josephgalloway321/IoT-Shed/README.md

# IoT Shed

Shed

The IoT Shed is a project focused on adding automation to an ordinary shed. Please watch this short [demonstration](https://youtu.be/3eUKjTSdYpM). The project includes remote light control, cooling the inside of the shed, and a website to control and monitor information remotely. My goal for this project was to help my dad automate some tasks in his shed while using skills that I learned from a course I recently took at Arizona State University, Programming for the Internet of Things.

This repository includes everything needed to make this project on your own. Please feel free to fork the code and schematics and make your own version. If you do, then please share your final version with me! I'd love to see how you improved upon my design for your own shed. I included a [future work](#future-work) section to provide some ideas.

___
## About this document
This document has two sections - a section giving an [overview](#overview) of how everything works and a section that provides a [step-by-step guide](#step-by-step-guide) for replicating this project on your own.

___
## Table of Contents
[Overview](#overview)
- [Website](#website)
- [Light Control](#light-control)
- [Shed Cooling](#fan-cooling)
- [Ceiling Control](#ceiling-control)
- [Battery Monitoring](#battery-monitoring)

[Step-by-Step Guide](#step-by-step-guide)
- [Components](#components)
- [Circuit](#circuit)
- [Code]()
- [Enclosure](#enclosure)
- [Bill of Materials](#bill-of-materials)
- [Future Work](#future-work)
- [Acknowledgements](#acknowledgments)

___
## Overview
This section shows a high level view of how everything in the IoT shed works. Please refer to the [Step-by-Step Guide](#step-by-step-guide) for instructions on how to make the project yourself.

This [video](https://www.youtube.com/watch?v=PkzvmJoyXTg) shows a demonstration with everything working.

### Website
The website is broken into four sections: ceiling slits, battery level, occupancy, and the temperature. The ceiling slits section is for monitoring the state of the ceiling slits, whether rain has been detected or not, and the status of the air compressor and releae valve. The battery level section is meant to indicate the current charge on the battery. The occupancy section is for monitoring if someone is currently in the shed or not. This will determine the status of the lights. The temperature section is for monitoring the indoor and outdoor temperatures as well as the state of the fan.

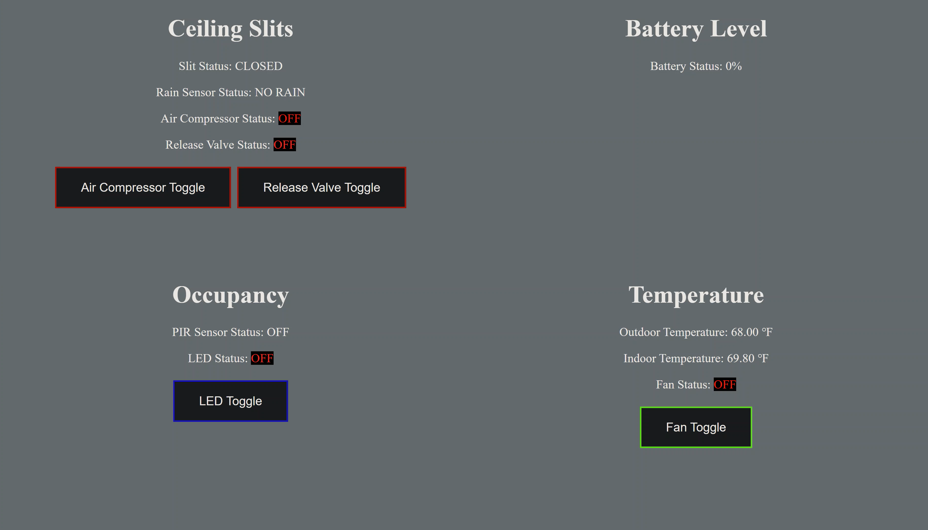
[picture p1: Images/website_design.png]


The ESP32 Relay Board will serve as a server that hosts the website. Anyone connected to the same WiFi can access the website. A simple concept visual is shown below.

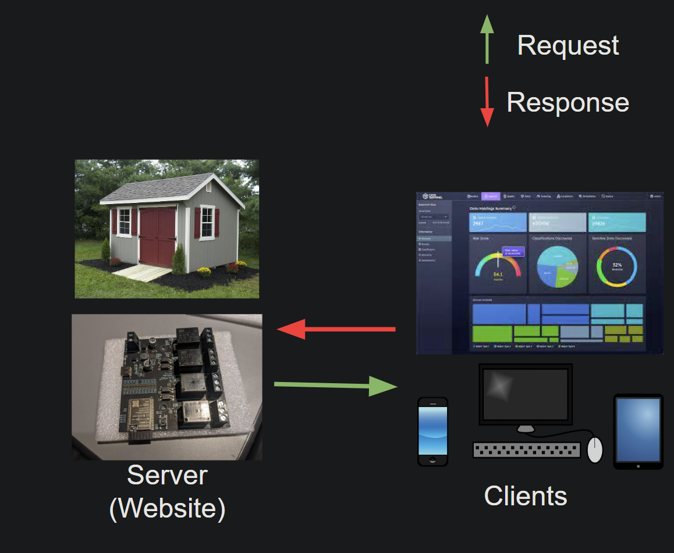
[picture p2: Images/concept.png]


Users can toggle the air compressor, release valve, fan, and lights using the website. The status of each will automatically update on the website. These toggle buttons were included mainly for testing, but I kept them so users can still have access to them. However, the goal of this project is to automate processes, so the buttons are not meant to be used often. 

### Light Control
My original intention was to automate the shed lights so that they turned on when someone entered, stayed on as long as someone was moving in the shed, and turned off when no one occupied the shed. Because of my limited time, I have not completed this section yet. The device I plan to use is called a Passive Infrared (PIR) sensor. More details on this sensor can be found in the [components](#components) section in the [step-by-step guide](#step-by-step-guide). For now, users can toggle the lights remotely using the website. I intend on completing this section soon. The LED strips are shown below.

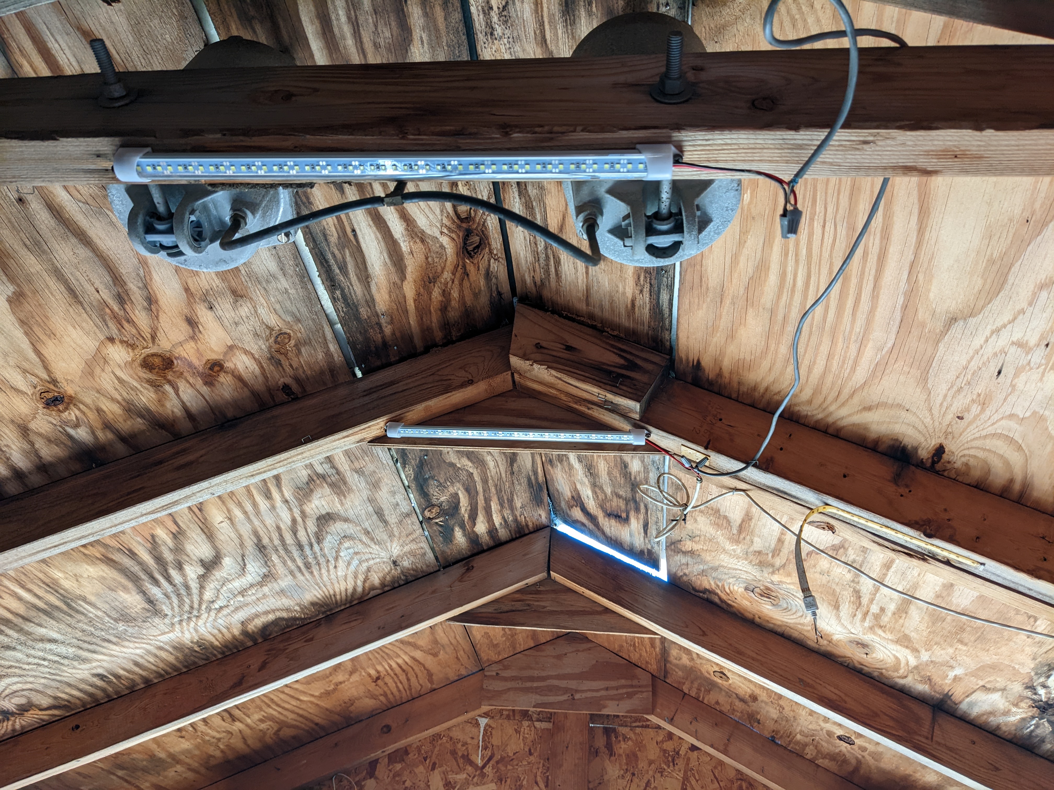
[picture p3: Images/lights.jpg]


### Shed Cooling
My home in Texas gets very hot. Throughout most of the year, the temperature inside my dad's shed is much hotter than it is outside. My dad's shed currently uses a fan and pneumatic actuators to open and close ceiling slits to cool down the shed. Before this project, both of these were controlled with switches. Now, both are controlled automatically using sensors. The image below shows the pneumatic actuators and the ceiling slits when they're closed.

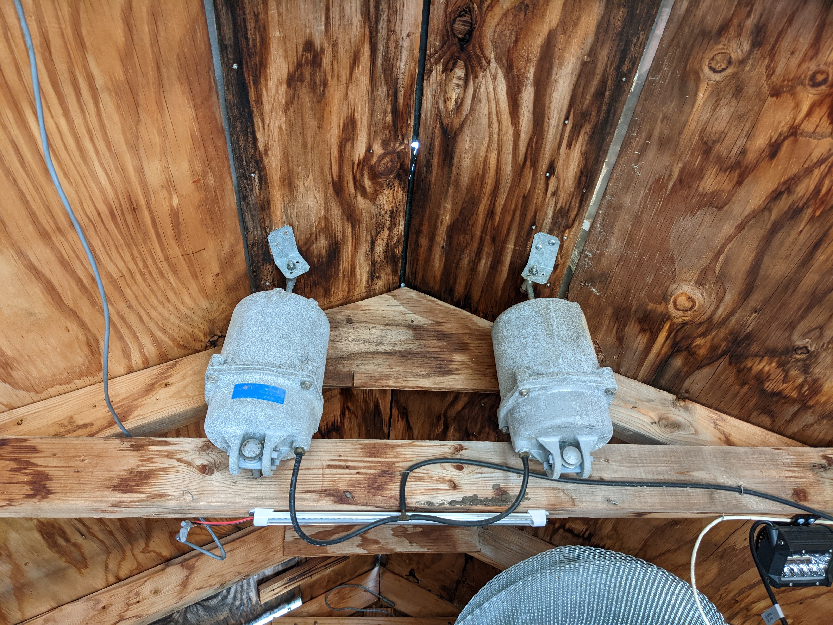
[picture p4: Images/actuators.jpg]


When the outside temperature rises 5&#176;F above the temperature inside the shed, the air compressor will turn on. The compressor will actuate the two pneumatic actuators installed just below the ceiling slits and open them. The process takes about twenty five seconds then the air compressor shuts off. As long as the ceiling slits are open, the air compressor will not turn on again regardless of the temperature differential. The ceiling slit status is determined by the limit switch installed just below one of the ceiling slits. The indoor and outdoor temperature sensors are shown below. The images below show what the ceiling slits look like when they're open.

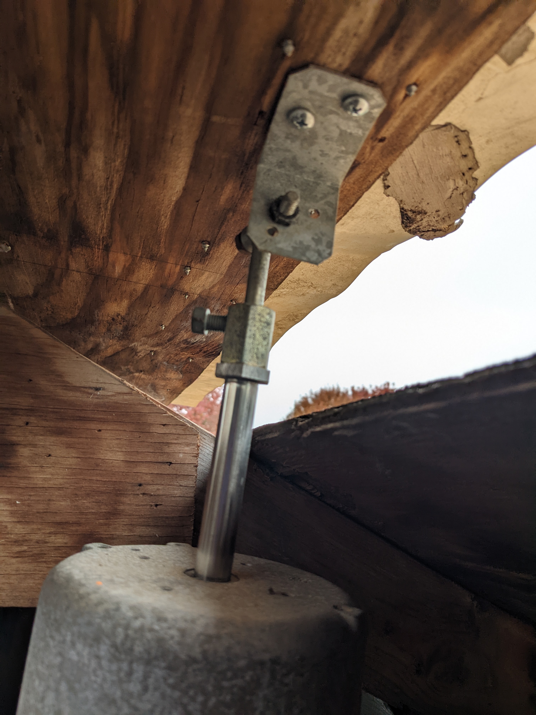
[picture p5: Images/ceiling_slits.jpg]

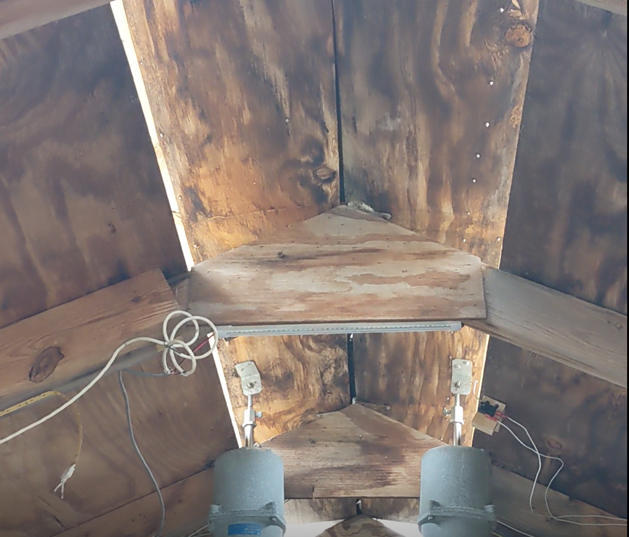
[picture p6: Images/ceiling_slits_two.png]


When the same temperature differential happens, the fan will turn on for a specific amount of time then pause for a different amount of time. This is meant to prevent the fan from running all day and draining the battery. The fan will help cool down the shed a little and keep air flowing, but it will not cool the shed down enough to change the temperature differential, which is why the fan should be paused after being used.

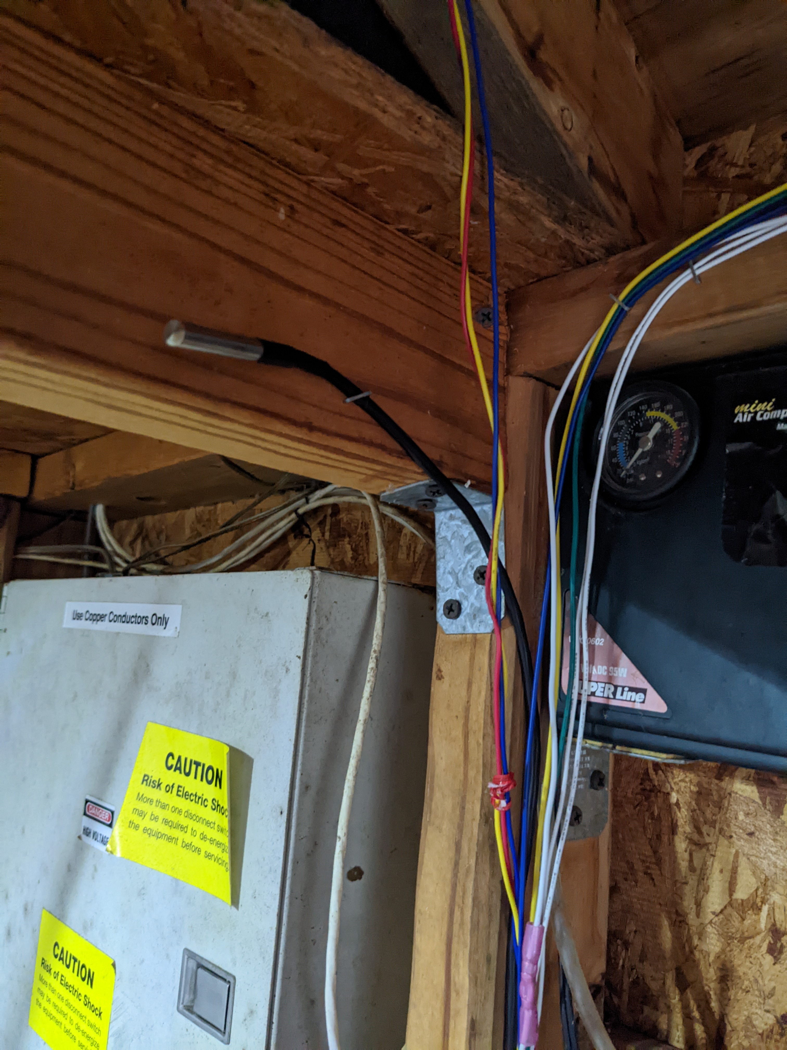
[picture p7: Images/indoor_temp.jpg]

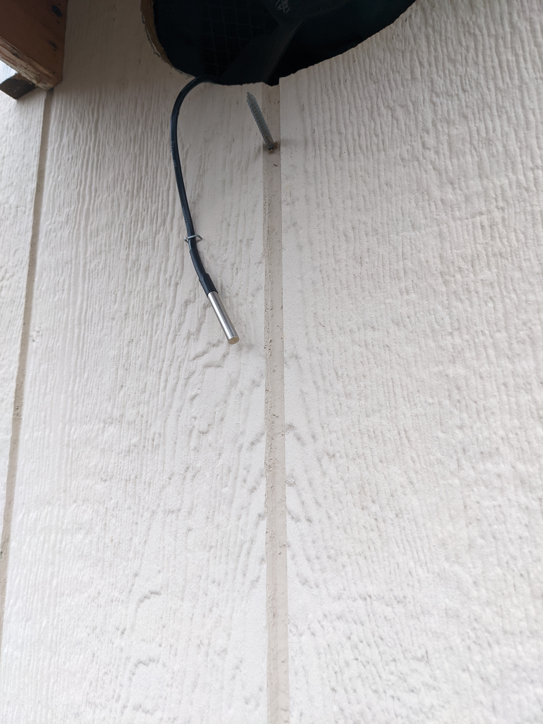
[picture p8: Images/outdoor_temp.jpg]


### Ceiling Control
As explained in the previous section, the ceiling slits are opening using an air compressor. When rain is detected by the rain sensor, the same slits are closed using a release valve. The processor for closing the slits is about ten seconds.

There is a pneumatic system made up of pipes used to control the air flow into and out of the pnemuatic actuators. An image of what I used is shown below. However, this is not necessary. All that is needed is the tubing shown in the bill of materials. This is for connecting the air compressor and the release valve to the pneumatic actuators.

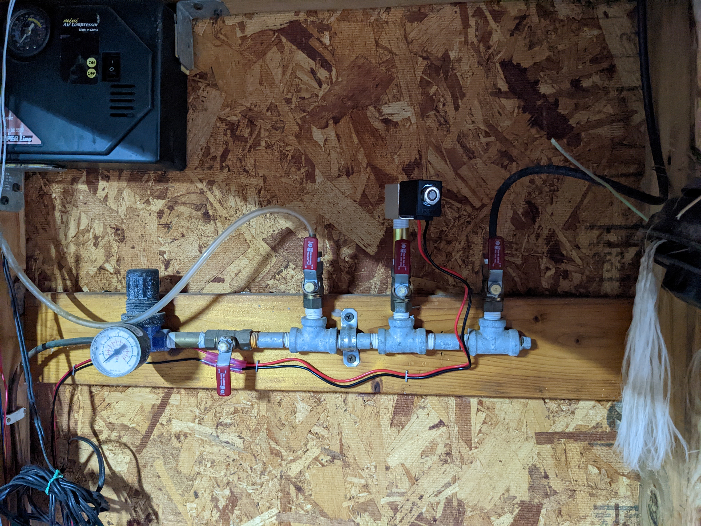
[picture p9: Images/pneumatic_valves.jpg]


### Battery Monitoring
My original intention was to show the current charge on the battery using the website. If the charge on the battery dropped below a set value, then an email would be sent to the user to charge the battery. Because of my limited time, I have not completed this section yet. The device I plan to use is an ina260 power sensor from Adafruit. More details on this sensor can be found in the [components](#components) section in the [step-by-step guide](#step-by-step-guide). For now, users can see where the battery charge will be located when this part is complete. The battery sensor I intend on using is shown below.

___
## Step-by-Step Guide
This section is a step-by-step guide for replicating the IoT Shed project. Please refer to the [Overview](#overview) for a high level view of how everything in the IoT shed works. 

### Components
Please begin the project by ordering all the components found in the [bill of materials](#bill-of-materials) section. It is assumed you already have a shed and a laptop to program. 

I highly recommend testing each component and circuit individually to make sure everything works the way it's intended. This will also give you some familiarity with everything at the start. More information for each sensor can be found on the website links found in the [bill of materials](#bill-of-materials) section. Each component shown below has a link to a brief tutorial showing you how to use them and a simple circuit for testing.
- [PIR Sensor](https://learn.adafruit.com/pir-passive-infrared-proximity-motion-sensor/overview)
- [Power Sensor](https://learn.adafruit.com/adafruit-ina260-current-voltage-power-sensor-breakout)
- [Temperature sensor](https://www.adafruit.com/product/381)
- [Limit Switch](https://youtu.be/6wuInF9Yw08)
- [Rain sensor](https://www.kemo-electronic.de/en/House/Garden/M152-Rain-Sensor-12-V-DC.php)

Please note that the TTGO T-U2T USB to TTL device found in the [bill of materials](#bill-of-materials) is required to program the ESP32 Relay Board. 

The limit switch needs a way to stay fixed under the ceiling slits so it can turn on and off when the slits are open and closed. The image below shows how I solved this issue. 

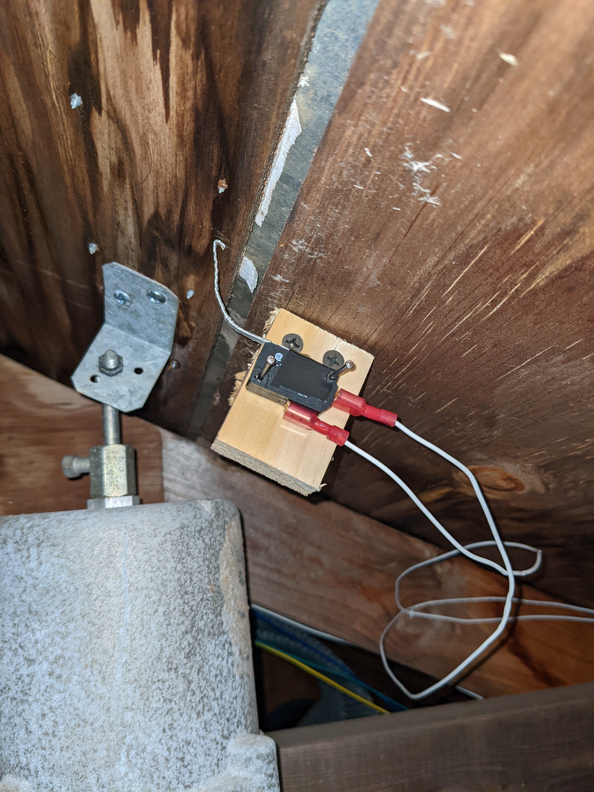
[picture p10: Images/limit_switch.jpg]

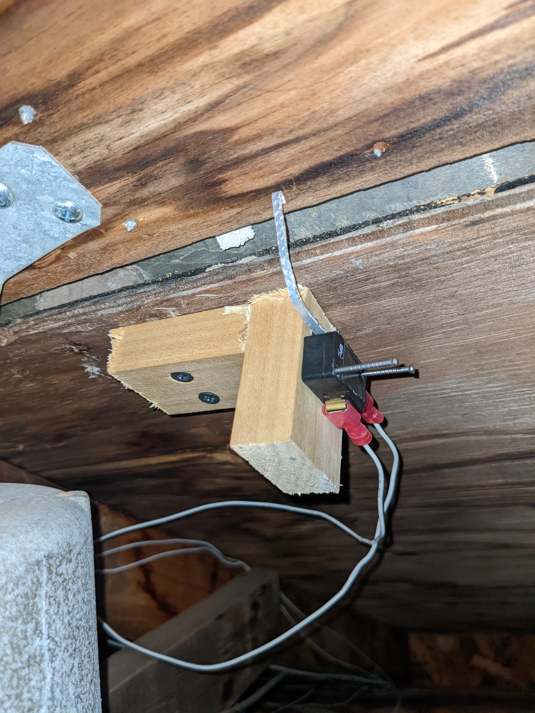
[picture p11: Images/limit_switch_two.jpg]


This device is made up of two 2"x4" blocks, four wood screws, two nails, and a thin piece of sheet metal to extend the limit switch lever. All of these materials are in the bill of materials. Screw the two blocks at a right angle and to a fixed part of the shed ceiling. Use two nails to fix the limit switch. Cut and glue a thin metal strip to the limit switch. Use two spade connectors to electrically connect to the limit switch.

The rain sensor needs to be placed at an angle so water will runoff of it and not collect onto the surface. All of the materials shown are in the bill of materials. Four screws were driven into the metal bracket and shed wall. The rain sensor was secured using metal wire. Test that water will run off the roof onto the sensor before permenantly installing.

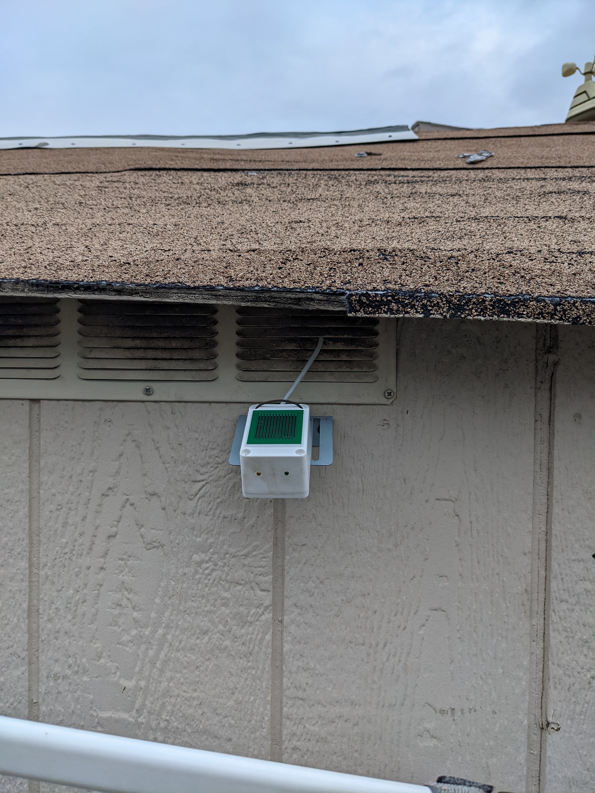
[picture p12: Images/rain_sensor.jpg]

Shed

### Circuit
When I began this project, I planned on getting all power from the 12V DC car battery already powering other devices in the shed. To prevent damage to components, I decided to use a buck regulator between the battery power and everything I planned to power. This regulator restricted the current to a maximum of 1 Amp. Please keep in mind the maximum allowable current for each device you plan on using.

The system's circuit is shown below. Note that the accessible GPIO pins have been placed on the top and bottom of the ESP32 relay board for readability. Also, the pull-up resistors shown are all 4.7k Ohm. Please note that the PIR sensor and the power sensors are not yet included in the final circuit.

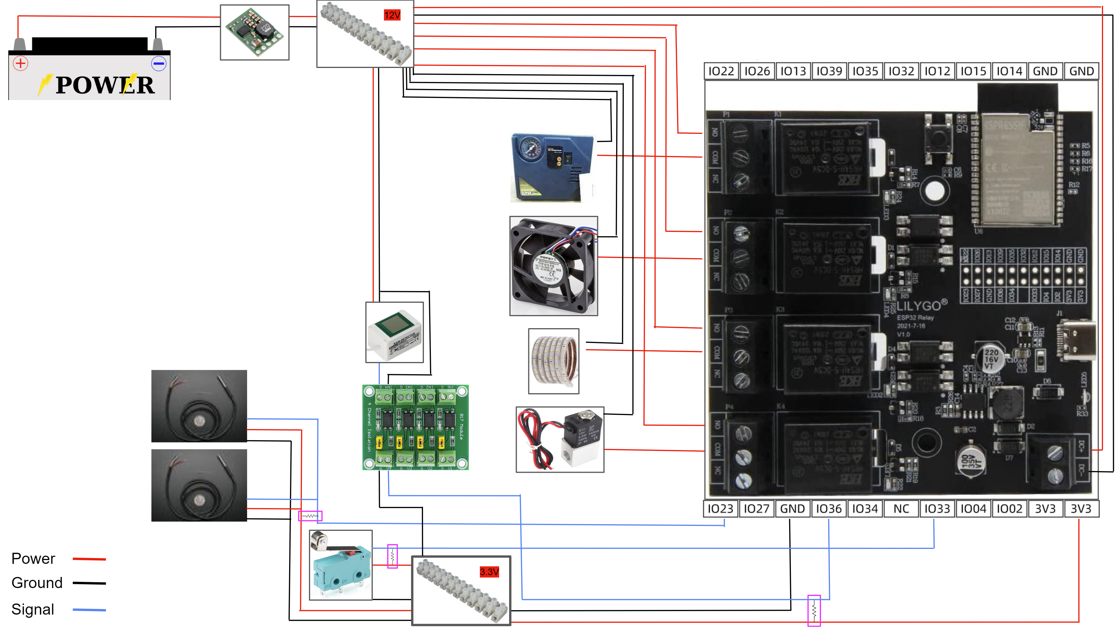
[picture p13: Images/overall_circuit.png]


The red lines indicate power wries, the black lines indicate ground wires, and the blue lines show the signal wires. Please make sure each component is powered and grounded appropriately. Once you have all of the components and tested each one, please assemble the circuit shown above. Note that the length of each wire will depend on how far each component will be placed in the shed relative to the ESP32 Relay Board.

The air compressor, the fan, the release valve, and the led strip are all controlled by the relays because they operate on a much higher voltage than the ESP32 relay board can provide. The other components can be powered using the battery or the 3.3V from the ESP32 relay board. 

When rain is detected, the rain sensor provides a 12V signal. This high voltage signal would destroy the ESP32 relay board if it was plugged directly into one of the GPIO pins. An optocoupler is used as an intermediate so that a 3.3V logic signal is sent to the ESP32 Relay Board when rain is detected.

### Code
There are four files of code: main.ino, index.html, style.css, and script.js. All of these can be found in the src folder in this repository. They are managed on the ESP32 relay board using SPIFFS. The main.ino file is the code for the server, sensor logic, and data transmission. The remaining three files all make up the website design and functionality. 

First, download the following libraries to your computer:
- [AsyncTCP](https://github.com/me-no-dev/AsyncTCP)
- [ESPAsyncWebServer
](https://github.com/me-no-dev/ESPAsyncWebServer)

Using the Arduino IDE, add the above libraries as well as these:
- WiFi.h
- Wire.h
- OneWire.h
- DallasTemperature.h

Next, install SPIFSS using this [tutorial](https://youtu.be/mkXsmCgvy0k). Please watch from 1:54 to 2:43.

Save the main.ino file into a folder labeled "main". Within the main folder, create a new folder labeled "data". Save the HTML, CSS, and Javascript files in this folder. Back in your Arduino IDE, click on "tools", then click on "ESP32 Sketch Data Upload". This will load the files in the data folder for the website. 

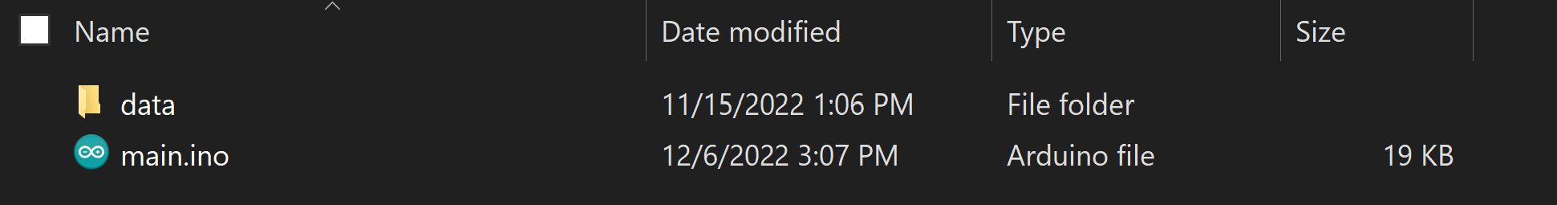
[picture p14: Images/files.png]

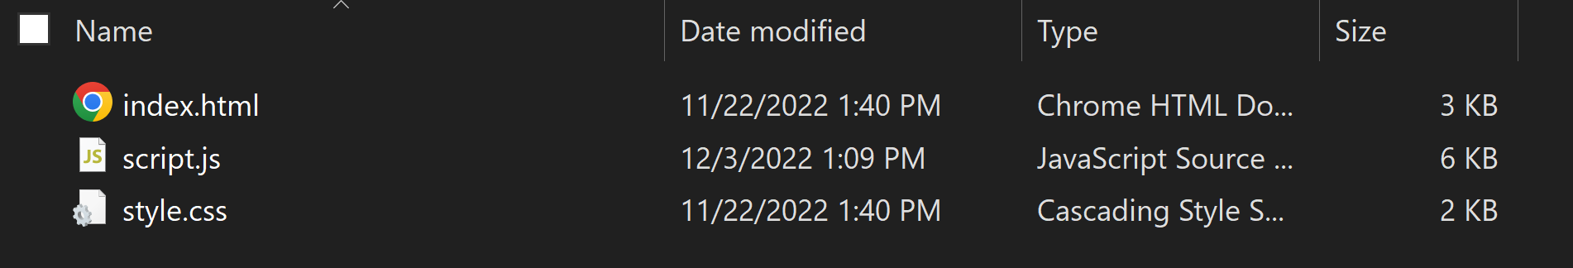
[picture p15: Images/files_two.png]


The next step is to get the wifi information needed to make a static IP address. In the main.ino file, Write in your wifi's SSID and password into the ssid and password variables at the top of the file. Run the program and open the serial monitor. You may need to press the reset button on the ESP32 Relay Board. After the program finishes connecting, the IP Address, Subnet Mask, Gateway IP, and DNS IP will be displayed. Please copy this information to the same variables at the top of the connectToWifiStatic() function. Copy the IP Address and rewrite it into the first line found in the script.js file.

Now, switch the program so it connects the static IP Address you recorded everytime you reset the program. Navigate to the setup function, uncomment the connectToWifiStatic() function, and comment the connectToWifi() function. Save each file, click on "tools", then click on "ESP32 Sketch Data Upload" to update the website information. Run the main.ino file in the Arduino IDE. Open the serial monitor to make sure the ESP32 Relay Board connects correctly. Open a brower and type in the static IP Address shown in the serial monitor. You should see the website pop up with correct sensor information. 

Shed

### Enclosure
The enclosure of the relay board is made out of acrylic and cut using a laser cutter provided by the Fab Lab at Arizona State University. The enclosure file, labeled board_enclosure.pdf, can be found in the additional_documentation folder in this repository.

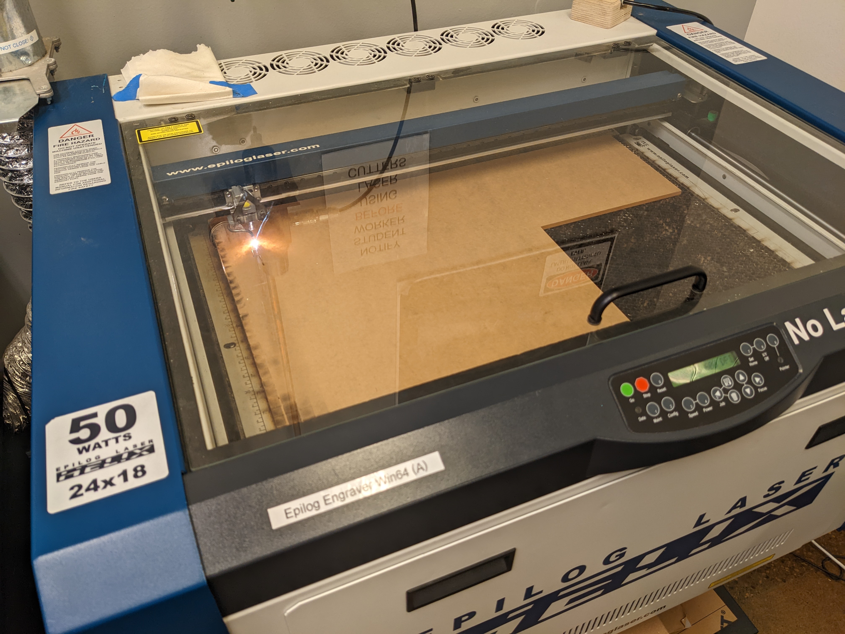
[picture p16: Images/relay_board_enclosure/laser_cutter.jpg]

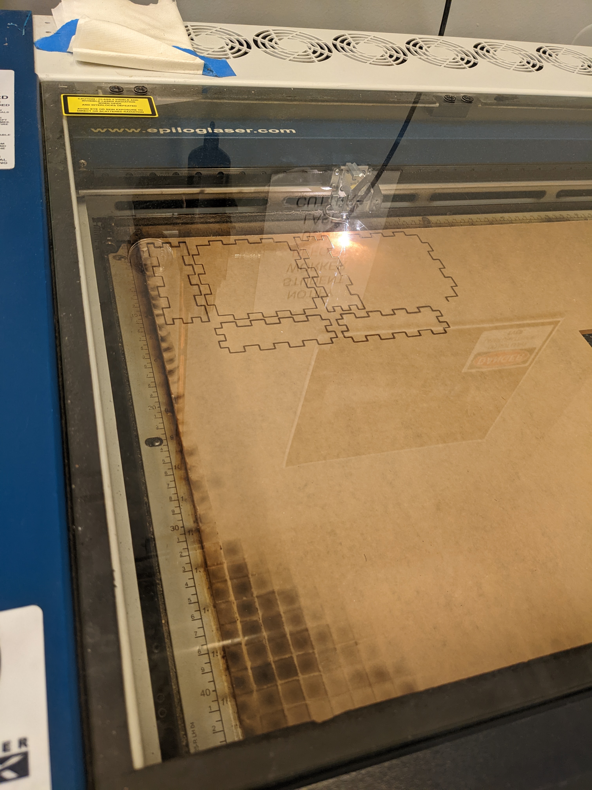
[picture p17: Images/relay_board_enclosure/laser_cutter_II.jpg]

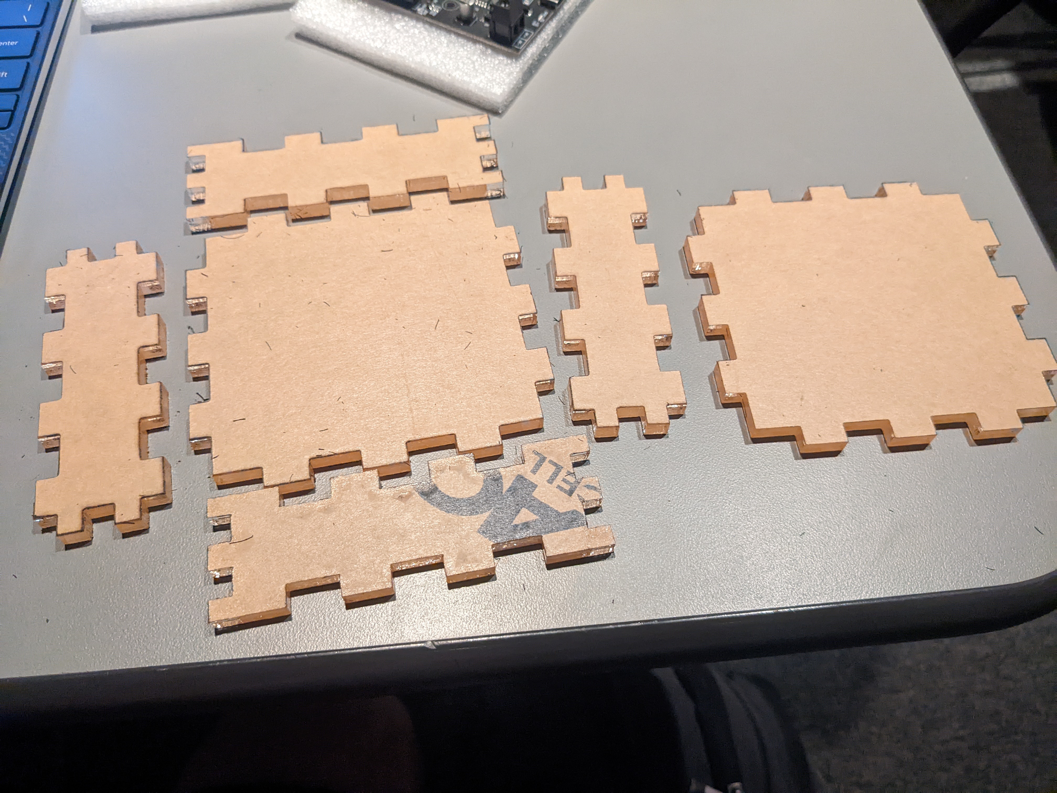
[picture p18: Images/relay_board_enclosure/enclosure.jpg]

Shed

The circuitry is currently not enclosed and exposed to the elements. I plan on making another enclosure for this in the near future.

### Bill of Materials
| Item | Price |
| ---- | ----  |
| [Battery](https://www.walmart.com/ip/EverStart-Value-Lead-Acid-Automotive-Battery-Group-Size-26-12-Volt-525-CCA/482504063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) | $60 |
| [Wire Strippers](https://www.amazon.com/Klein-Tools-Cutter-Stripper-Stranded/dp/B00080DPNQ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) | $20 |
| [Spade Connectors](https://www.amazon.com/TICONN-Disconnect-Connectors-Electrical-Assortment/dp/B08BZ8BLJN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) | $20 |
| [Wire Connectors & Crimpers](https://www.amazon.com/haisstronica-Connectors-Electrical-Waterproof-Removable/dp/B09GLKX7ZX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) | $55 |
| [Wood Screws](https://www.amazon.com/HongWay-Phillips-Assortment-Tapping-Drywall/dp/B08CZJK8SW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) | $8 |
| [Wood Nails](https://www.amazon.com/Premium-Hardware-Assortment-Maximum-Galvanized/dp/B089FLMFPB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) | $7 |
| [Drill](https://www.amazon.com/BLACK-DECKER-Cordless-Driver-BDCDD12C/dp/B0111N8L7I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) | $30 |
| [Breadboard & Jumper Wires](https://www.amazon.com/BOJACK-Values-Solderless-Breadboard-Flexible/dp/B08Y59P6D1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) | $12 |
| [Soldering Kit](https://www.amazon.com/Soldering-Kit-Temperature-Desoldering-Electronics/dp/B07GTGGLXN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) | $20 |
| [Limit Switch](https://www.amazon.com/REDGOOSE-Switch-Normally-3X10PCS-Switches/dp/B0B7DD5SF1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) | $9 |
| [Terminal Blocks](https://www.amazon.com/Terminal-Connector-Electric-Barrier-12-Position/dp/B08NGBQWWT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) | $10 |
| [Pneumatic Actuators](https://www.amazon.com/Baomain-Pneumatic-Cylinder-SC-Screwed/dp/B01F9XZQ1K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) | $21 |
| [Fan](https://www.amazon.com/GDSTIME-80mm-25mm-Brushless-Cooling/dp/B00N1Y50QQ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) | $9 |
| [Air Compressor](https://www.ebay.com/itm/265713472217) | $32 |
| [Passive Infrared (PIR) Sensor](https://www.adafruit.com/product/189) | $10 |
| [Indoor & Outdoor Temperature Sensor](https://www.adafruit.com/product/381) | $10 |
| [Power Sensor](https://www.adafruit.com/product/4226) | $10 |
| [Release Valve](https://www.amazon.com/4inch-Normally-Closed-Electric-Solenoid/dp/B074Z5SDG3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) | $10 |
| [Rain Sensor](https://www.amazon.com/dp/B000NI2QJC?psc=1&ref=ppx_yo2ov_dt_b_product_details) | $35 |
| [LEDs](https://www.amazon.com/WELLUCK-Interior-Trailer-Enclosed-Lighting/dp/B08GG18HVW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) | $20 |
| [ESP32 w/ Relays](https://www.amazon.com/LILYGO-T-Relay-Wireless-Development-Control/dp/B09XX1HL9Z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) | $20 |
| [TTGO T-U2T USB to TTL](https://www.walmart.com/ip/OOKWE-LILYGO-TTGO-T-U2T-USB-To-TTL-Serial-Development-Board-Open-Source-Module/1405355347) | $17 |
| [Wires](https://www.amazon.com/dp/B089CW7YSR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) | $30 |
| [Pneumatic Tubing](https://www.amazon.com/CGELE-Pneumatic-Transfer-OD-39-4Ft-12Meter/dp/B09KBM3J5K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) | $14 |
| [Wood Blocks](https://www.amazon.com/Bright-Creations-Unfinished-Blocks-Crafts/dp/B07R51CY99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) | $12 |
| [Metal Wire](https://www.amazon.com/TecUnite-Aluminum-Bendable-Skeleton-Thickness/dp/B07CQL7Y5B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) | $13 |
| [Metal Bracket](https://www.amazon.com/5pcs-Metal-Bracket-Wide-40x50x50mm/dp/B0BK9XYNDS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) | $15 |
| [Sheet Metal](https://www.amazon.com/Sheet-Metal-Stock-Made-USA/dp/B000H5W3PI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) | $7 |

### Future Work
This section provides some ideas for you to build upon my version. They're just ideas I thought of while I was working on this project.
- Bluetooth speakers
- External antenna
- Fan to keep relay board cool with a temperature sensor dedicated to the relay board
- Better website design
- Solar panel to charge the battery
- Battery monitor for solar panel

### Acknowledgments
The following is my work cited:
- ShawnHymel. (2018, November 1). How to make an Arduino WebSocket server with an ESP32. YouTube. Retrieved November 5, 2022, from https://www.youtube.com/watch?v=ZbX-l1Dl4N4
- YouTube. (2019, January 6). PC817 adapter module Optocoupler with Arduino - Zonemaker.com. YouTube. Retrieved November 6, 2022, from https://www.youtube.com/watch?v=dD4r5I7h4Xg
- How to create a web server (with WebSockets) using an ESP32 in Arduino. Shawn Hymel. (2019, September 9). Retrieved November 7, 2022, from https://shawnhymel.com/1882/how-to-create-a-web-server-with-websockets-using-an-esp32-in-arduino/ 
- Googlecreativelab, Magenta, McDonald, K., & RRD Labs. (n.d.). Googlecreativelab/open-NSYNTH-super: Open NSYNTH super is an experimental physical interface for the NSYNTH algorithm. GitHub. Retrieved December 8, 2022, from https://github.com/googlecreativelab/open-nsynth-super#how-it-works 
- Gowda, T. (n.d.). Tejaswigowda/AME494-598FALL2022. GitHub. Retrieved December 8, 2022, from https://github.com/tejaswigowda/ame494-598Fall2022 

[Back to Top of Webpage](#iot-shed)
