josephgalloway321/IoT-Shed/Images/air_compressor.jpg

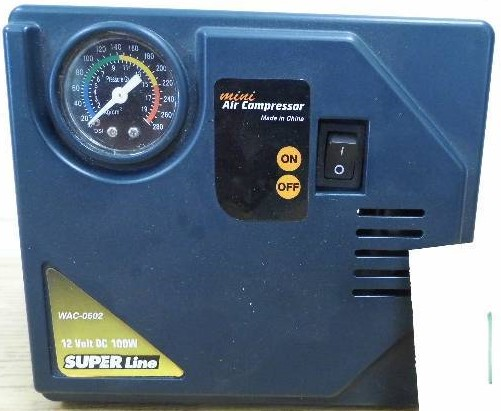
Images/air_compressor.jpg
