josephgalloway321/IoT-Shed/Images/battery.jpg

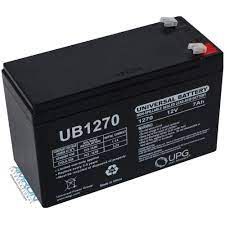
Images/battery.jpg
