josephgalloway321/IoT-Shed/Images/led.jpg

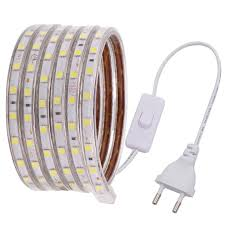
Images/led.jpg
