josephgalloway321/IoT-Shed/Images/optocoupler.jpg

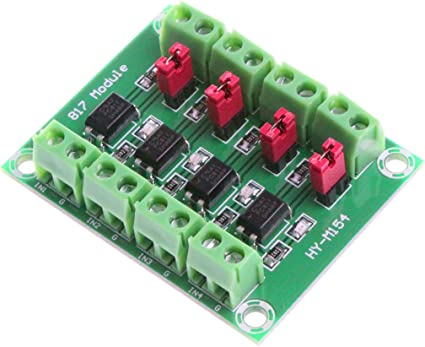
Images/optocoupler.jpg
