josephgalloway321/IoT-Shed/Images/pir_sensor.jpg

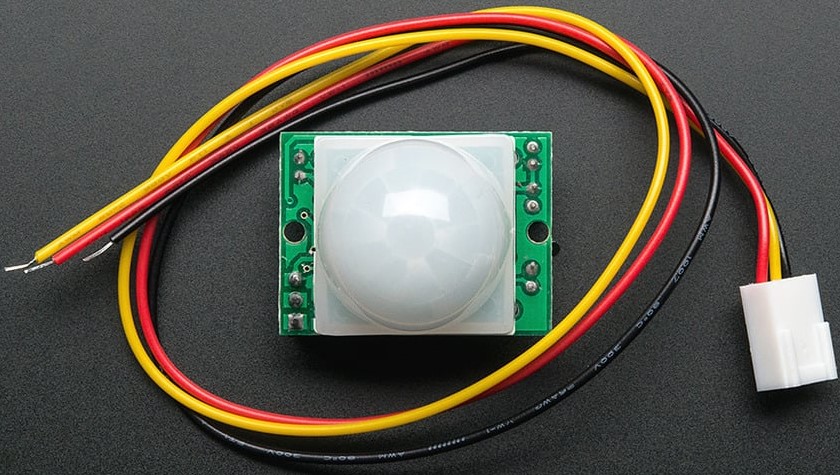
Images/pir_sensor.jpg
