josephgalloway321/IoT-Shed/Images/power_sensor.jpg

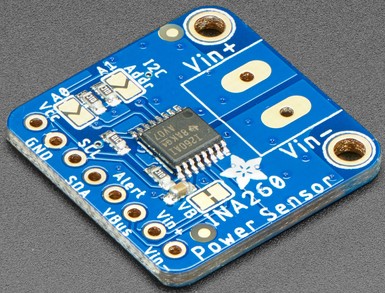
Images/power_sensor.jpg
