josephgalloway321/IoT-Shed/Images/relay_board.jpg

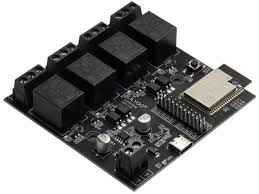
Images/relay_board.jpg
