josephgalloway321/IoT-Shed/Images/release_valve.jpg

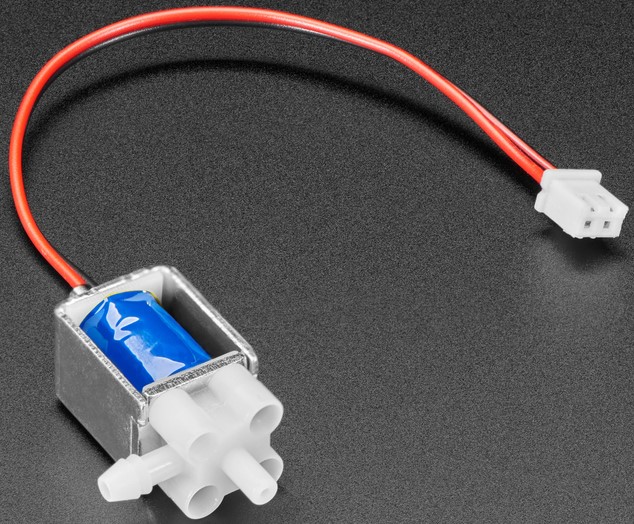
Images/release_valve.jpg
