josephgalloway321/IoT-Shed/Images/t_u2t.png

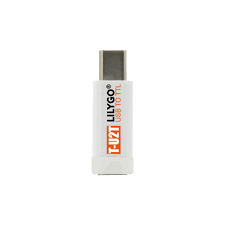
Images/t_u2t.png
