josephgalloway321/IoT-Shed/Images/temp_sensor.jpg

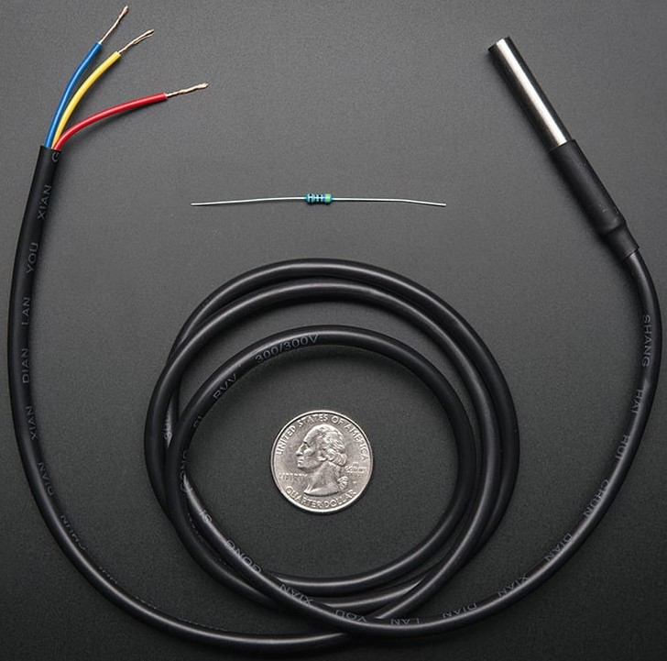
Images/temp_sensor.jpg
