josephgalloway321/IoT-Shed/Images/terminal_blocks.jpg

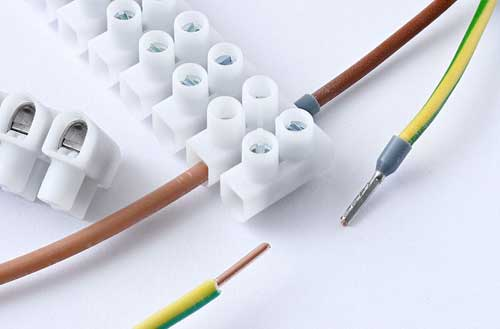
Images/terminal_blocks.jpg
