josephgalloway321/IoT-Shed/additional_documentation/schematic.pdf

# Schematic

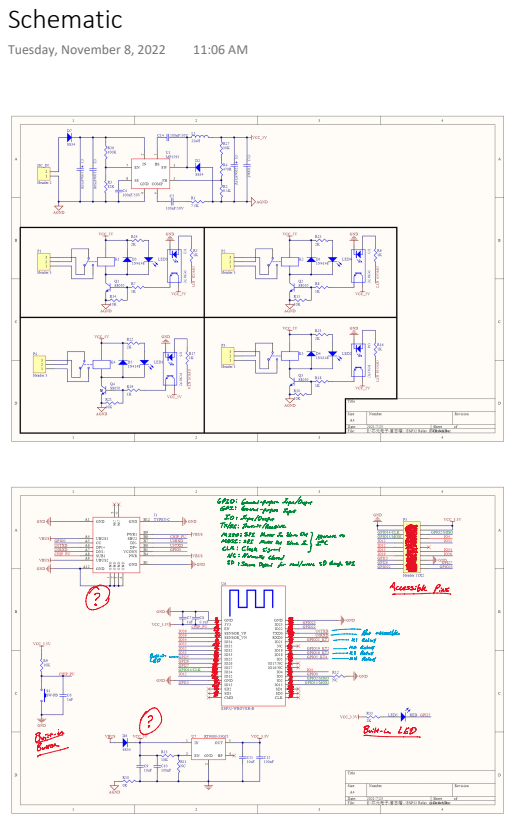
[picture p30: page 1]
Tuesday, November 8, 2022
